awygle/smolfpga/smolfpga.pdf

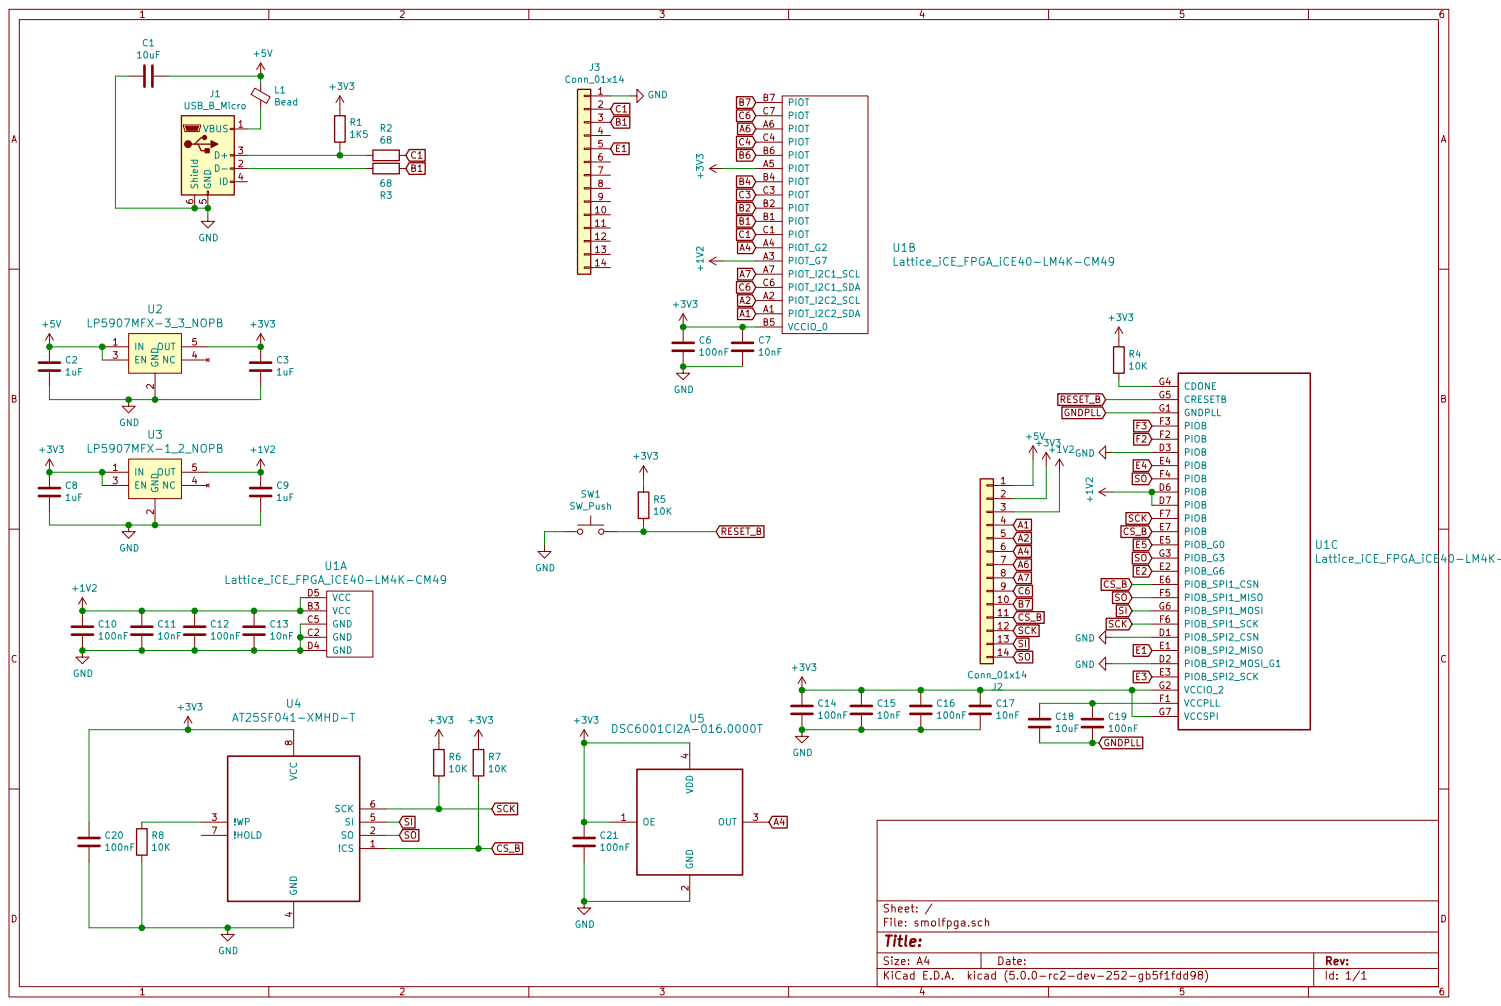
[picture p1: page 1]

File: smolfpga.sch Sheet: /
Id: 1/1 Title:
