awygle/smolfpga/smolfpga.kicad_pcb

## KiCad design smolfpga.kicad_pcb (2018-04-05)

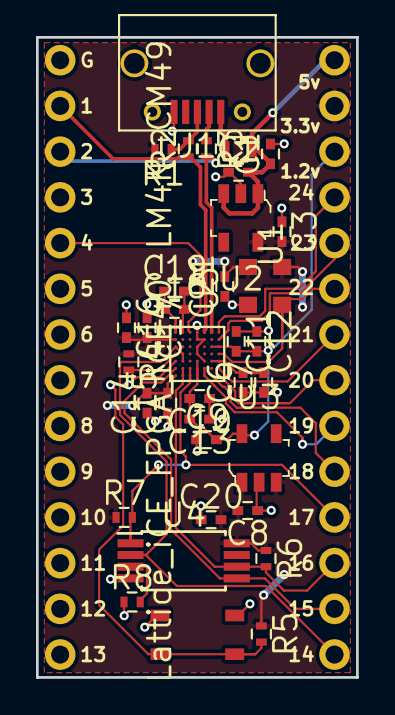
[picture p2: board smolfpga.kicad_pcb from above]

Board: 2 copper layers, 17.8 x 35.6 mm, 37 parts (0 on the bottom side), 26 nets.

Parts:
C1: 10uF; C_0402
C2, C3, C8, C9: 1uF; C_0402
C6, C10, C12, C20, C21: 100nF; C_0402
C7, C11, C13: 10nF; C_0402
C14, C15, C16, C17, C18, C19: C; C_0402
J1: USB_B_Micro; USB_Micro-B
J2, J3: Conn_01x14; Pin_Header_Straight_1x14_Pitch2.54mm
L1: Ferrite_Bead_Small; L_0603
R1: 1K5; R_0402
R2, R3: 68; R_0402
R4, R5: R; R_0402
R6, R7, R8: 10K; R_0402
SW1: SW_Push; PTS_810_SMT_Switch
U1: Lattice_iCE_FPGA_iCE40-LM4K-CM49; VFBGA-49
U2: LP5907MFX-3_3_NOPB; SOT-753
U3: LP5907MFX-1_2_NOPB; SOT-753
U4: AT25SF041-XMHD-T; TSSOP-8_4.4x3mm_Pitch0.65mm
U5: DSC6001CI2A-016.0000T; CDFN3225-4LD-PL-1

Connections:
+1V2: C9.2, C10.2, C11.2, C12.2, C13.2, J2.3, U1.A3, U1.B3, U1.D5, U1.D6, U1.D7, U3.5
+3V3: C3.2, C6.2, C7.2, C8.2, C14.2, C15.2, C16.2, C17.2, C20.2, C21.2, J2.2, R1.2, R4.1, R5.1, R6.1, R7.1, U1.A5, U1.B5, U1.G2, U1.G7, U2.5, U3.1, U3.3, U4.8, U5.1, U5.4
+5V: C1.1, C2.2, J2.1, L1.1, U2.1, U2.3
A1: J2.4, U1.A1
A2: J2.5, U1.A2
A4: J2.6, U1.A4, U5.3
A6: J2.7, U1.A6
A7: J2.8, U1.A7
B1: J3.3, R3.2, U1.B1
B7: J2.10, U1.B7
C1: J3.2, R2.1, U1.C1
C6: J2.9, U1.C6, U1.C7
CS_B: J2.11, R7.2, U1.E6, U1.E7, U4.1
E1: J3.5, U1.E1
GND: C1.2, C2.1, C3.1, C6.1, C7.1, C8.1, C9.1, C10.1, C11.1, C12.1, C13.1, C14.1, C15.1, C16.1, C17.1, C20.1, C21.1, J1.5, J1.6, J3.1, R8.1, SW1.1, U1.C2, U1.C5, U1.D1, U1.D2, U1.D3, U1.D4, U2.2, U3.2, U4.4, U5.2
GNDPLL: C18.1, C19.1, U1.G1
unnamed: C18.2, C19.2, U1.F1
unnamed: J1.1, L1.2
unnamed: J1.2, R3.1
unnamed: J1.3, R1.1, R2.2
unnamed: R4.2, U1.G4
unnamed: R8.2, U4.3
RESET_B: R5.2, SW1.2, U1.G5
SCK: J2.12, R6.2, U1.F6, U1.F7, U4.6
SI: J2.13, U1.G6, U4.5
SO: J2.14, U1.F4, U1.F5, U1.G3, U4.2
