awygle/smolfpga/(commit log)

2018-04-01 Design files commit.
    [smolfpga.kicad_pcb, smolfpga.sch]
2018-04-05 Added additional required files, fabrication outputs, BOM, and schematic PDF.
    [smolfpga-B.Cu.gbr, smolfpga-B.Mask.gbr, smolfpga-B.Paste.gbr, smolfpga-B.SilkS.gbr, smolfpga-Edge.Cuts.gbr, smolfpga-F.Cu.gbr, smolfpga-F.Mask.gbr, smolfpga-F.Paste.gbr]
